JoseFuzzNo/performer-hardware/sequencer.pdf

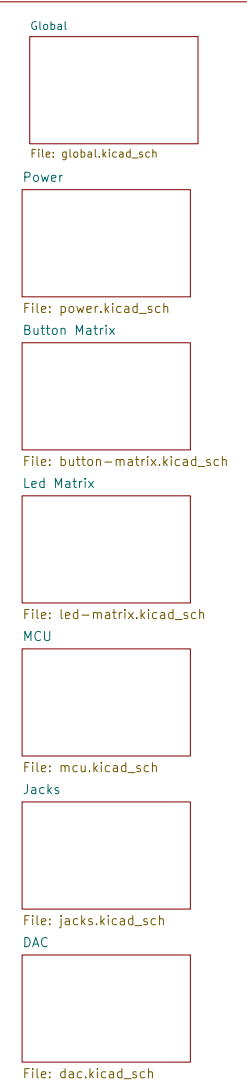
[picture p1: page 1]

Power File: power.kicad_sch Button Matrix File: button-matrix.kicad_sch

Led Matrix File: led-matrix.kicad_sch

File: sequencer.kicad_sch Sheet: / westlicht cc-by-nc-sa

Id: 1/8 Title: PER|FORMER eurorack sequencer

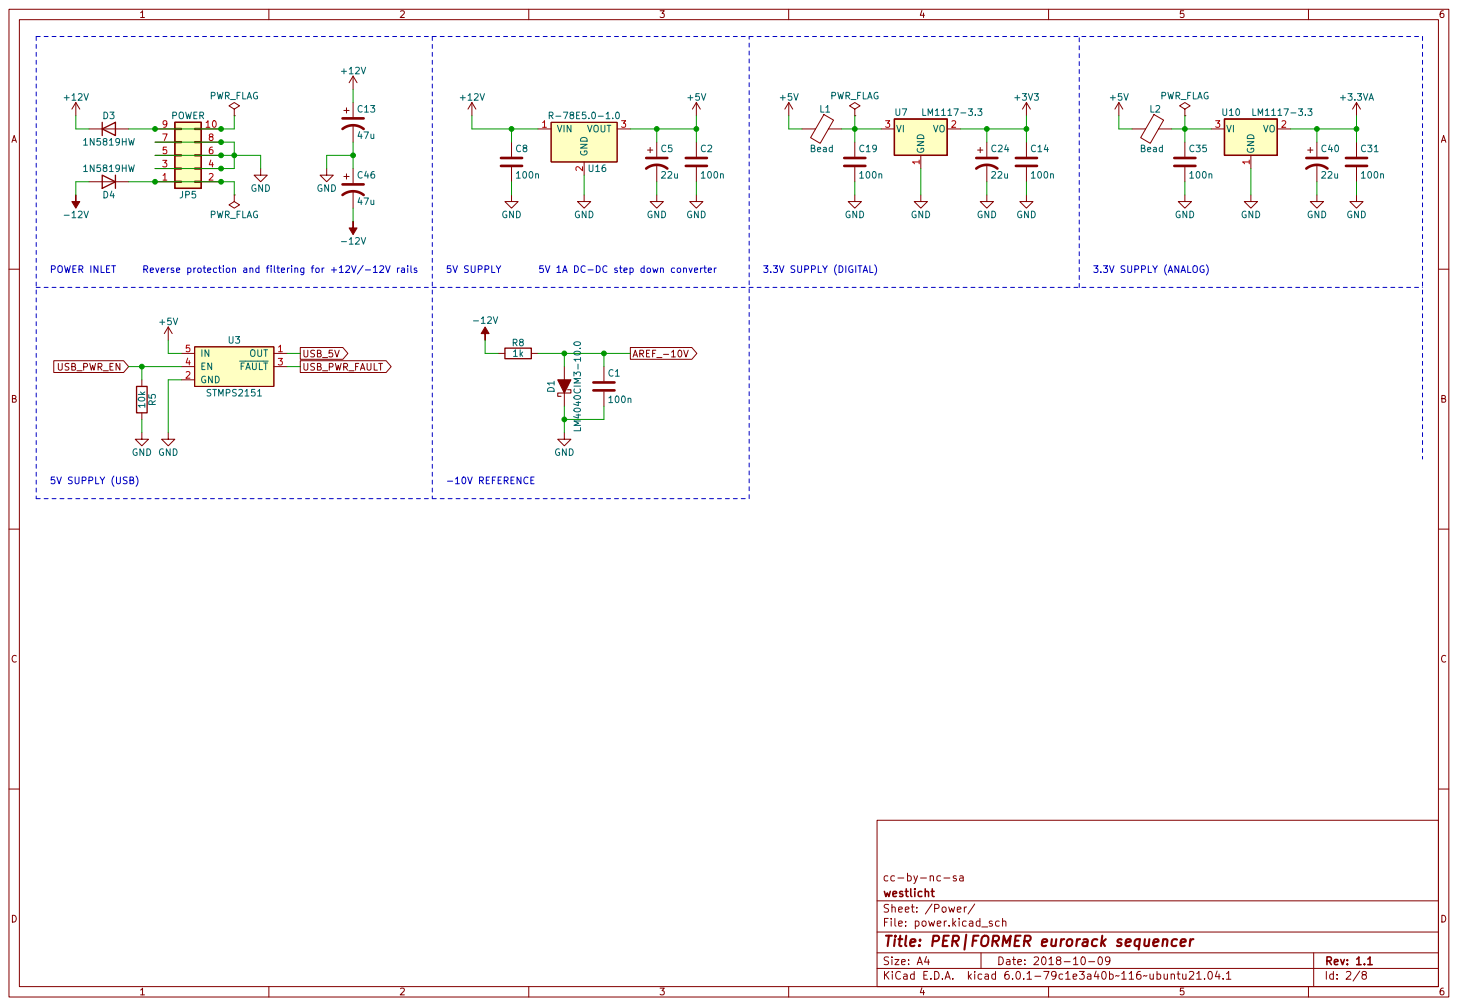
[picture p2: page 2]

Id: 2/8 Title: PER|FORMER eurorack sequencer

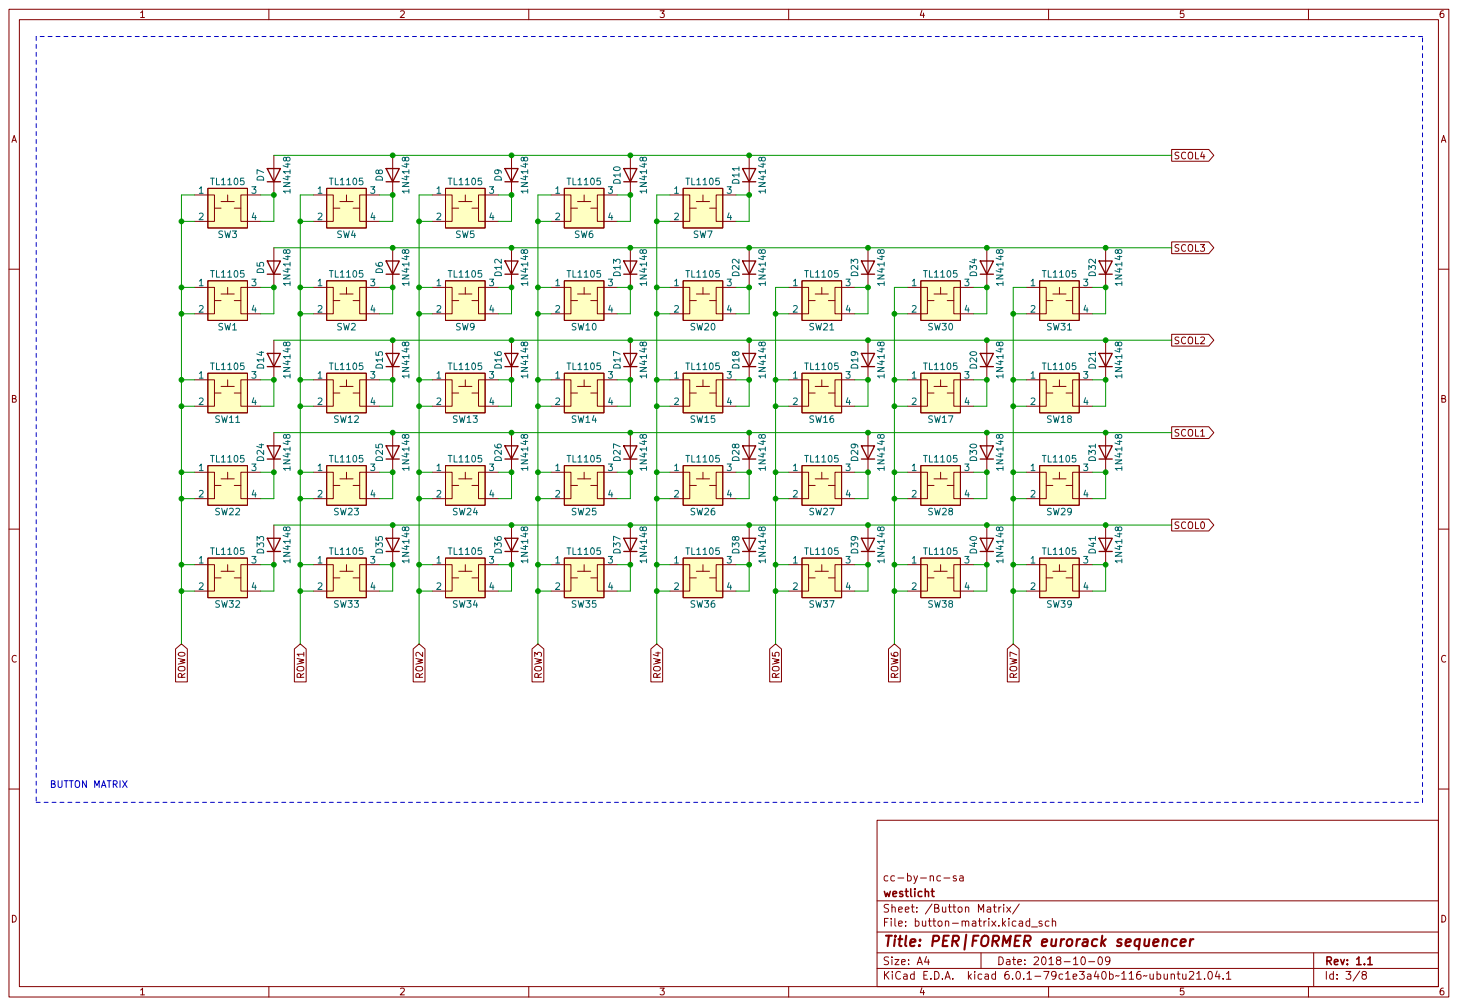
[picture p3: page 3]

File: button-matrix.kicad_sch Sheet: /Button Matrix/ westlicht cc-by-nc-sa

Id: 3/8 Title: PER|FORMER eurorack sequencer

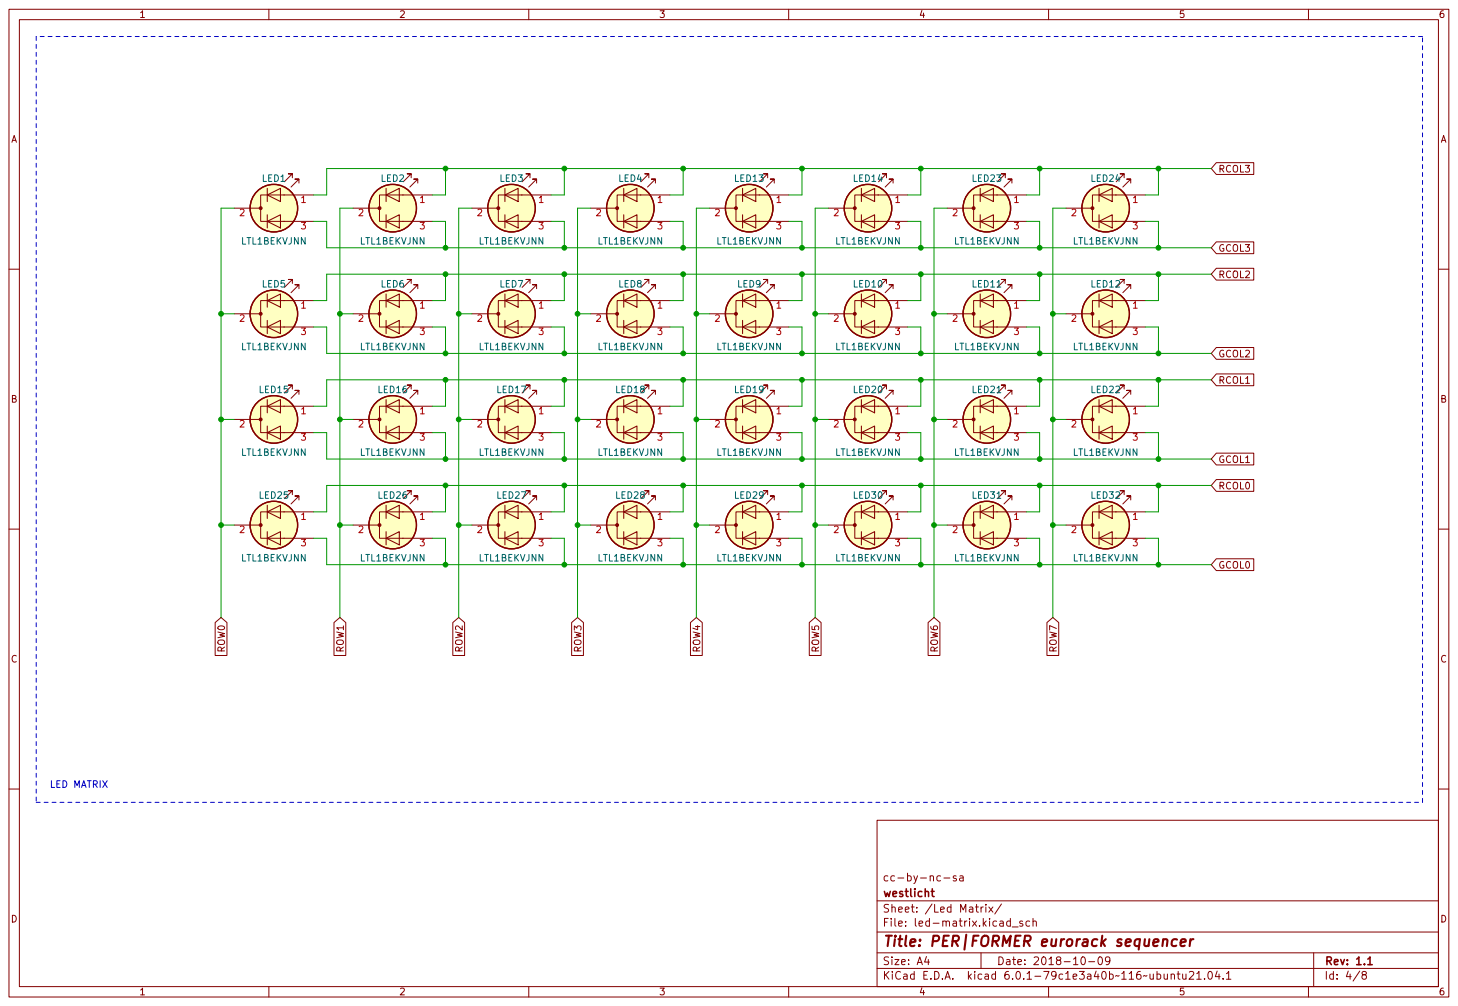
[picture p4: page 4]

File: led-matrix.kicad_sch Sheet: /Led Matrix/ westlicht cc-by-nc-sa

Id: 4/8 Title: PER|FORMER eurorack sequencer

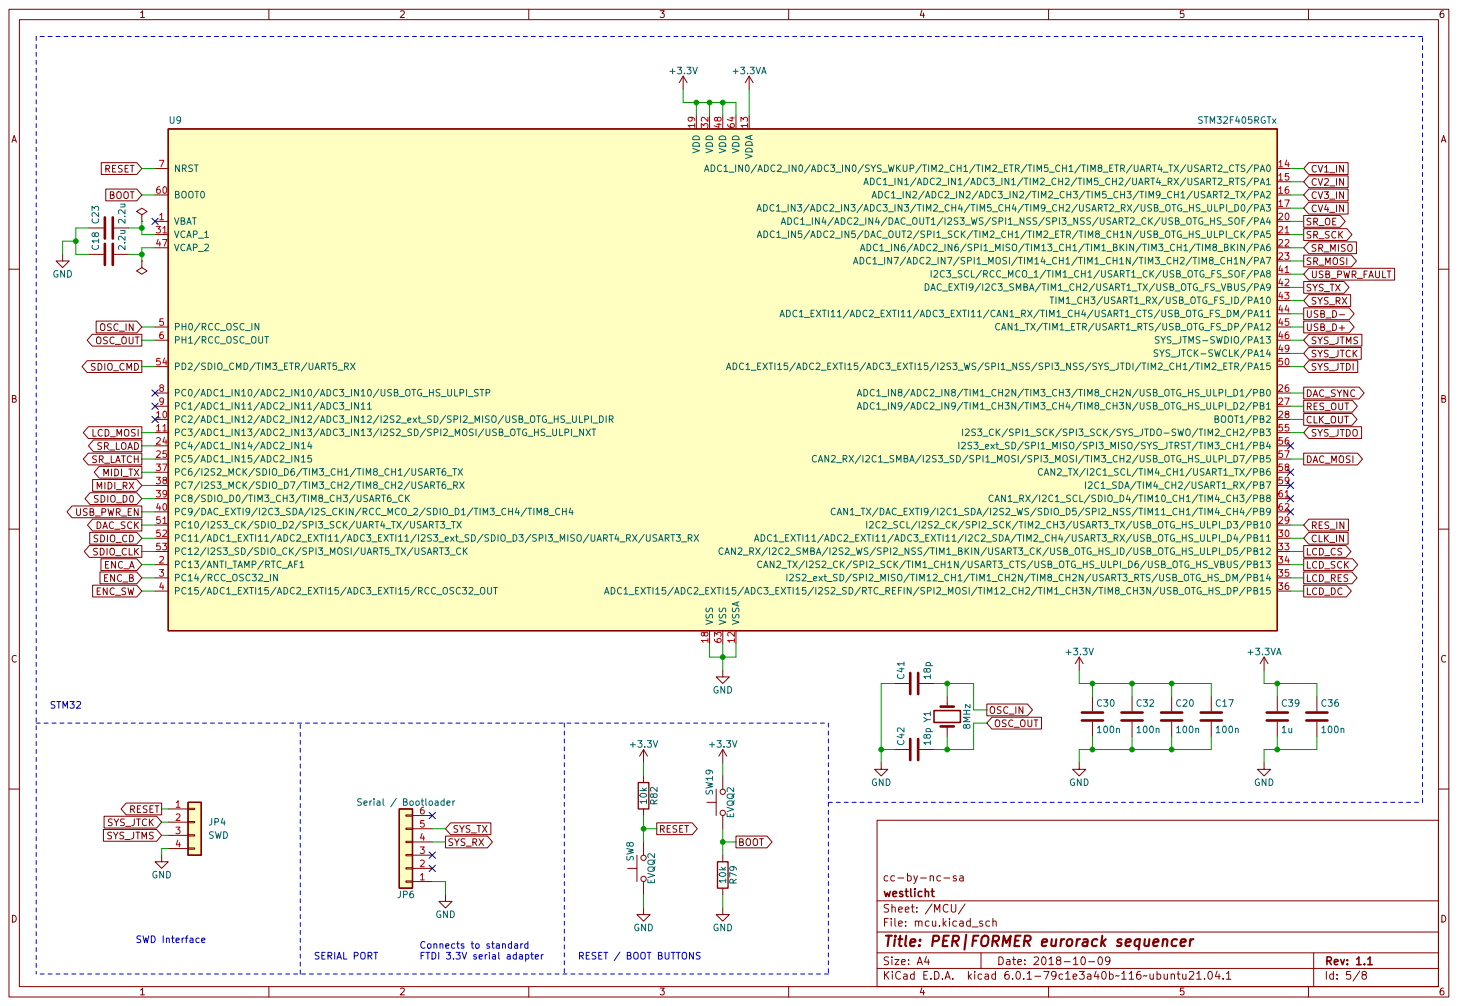
[picture p5: page 5]

Id: 5/8 Title: PER|FORMER eurorack sequencer

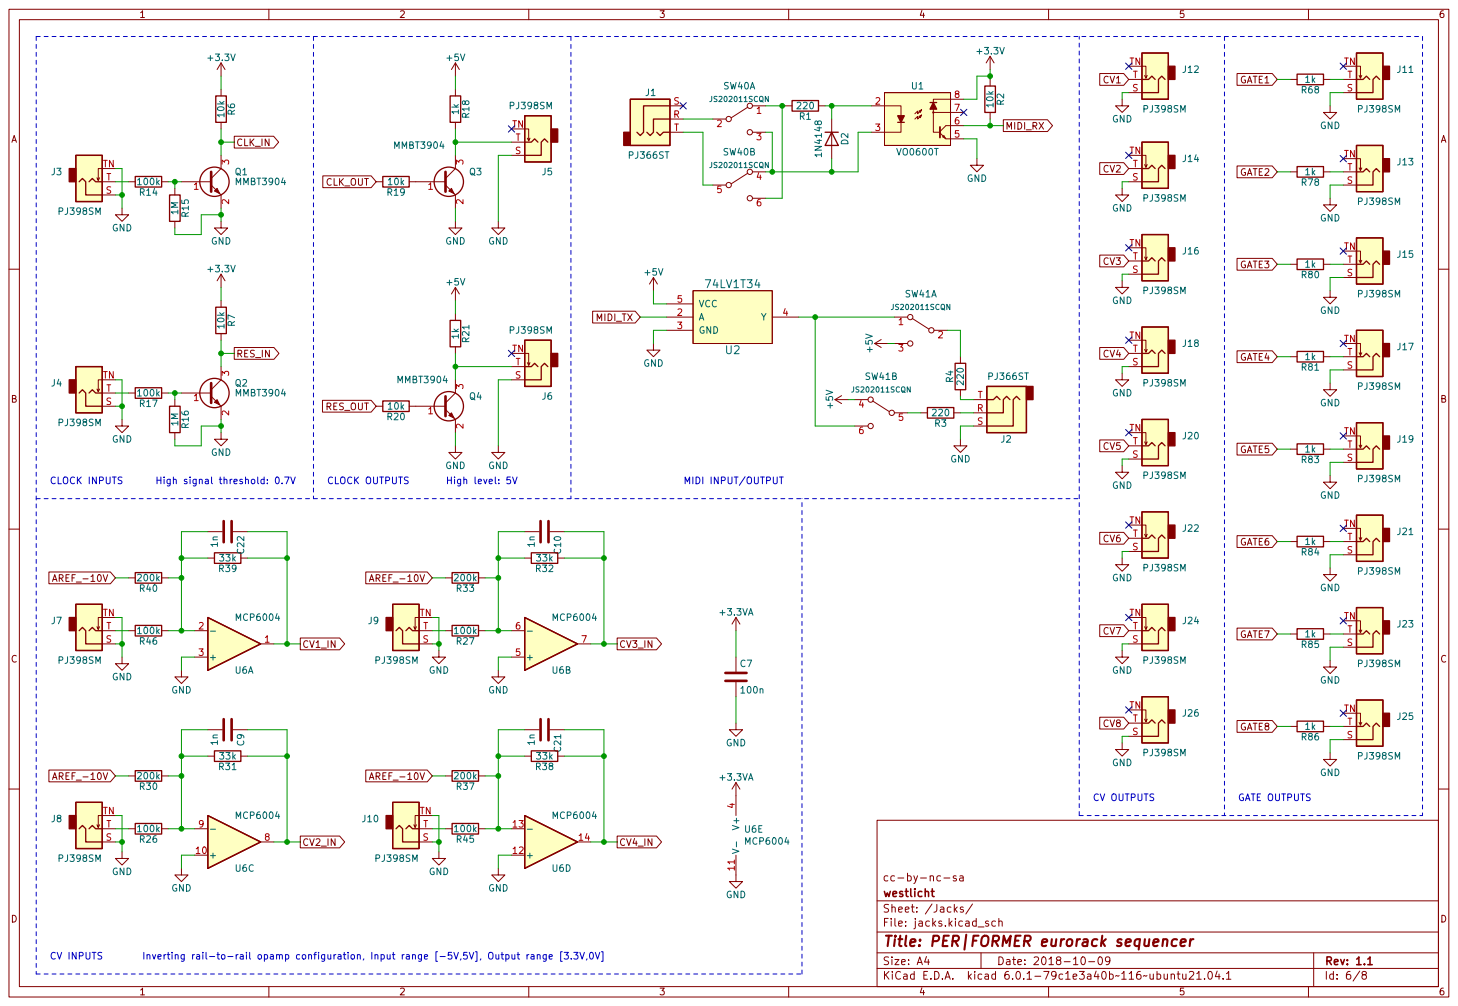
[picture p6: page 6]

File: jacks.kicad_sch Sheet: /Jacks/ westlicht cc-by-nc-sa

Id: 6/8 Title: PER|FORMER eurorack sequencer

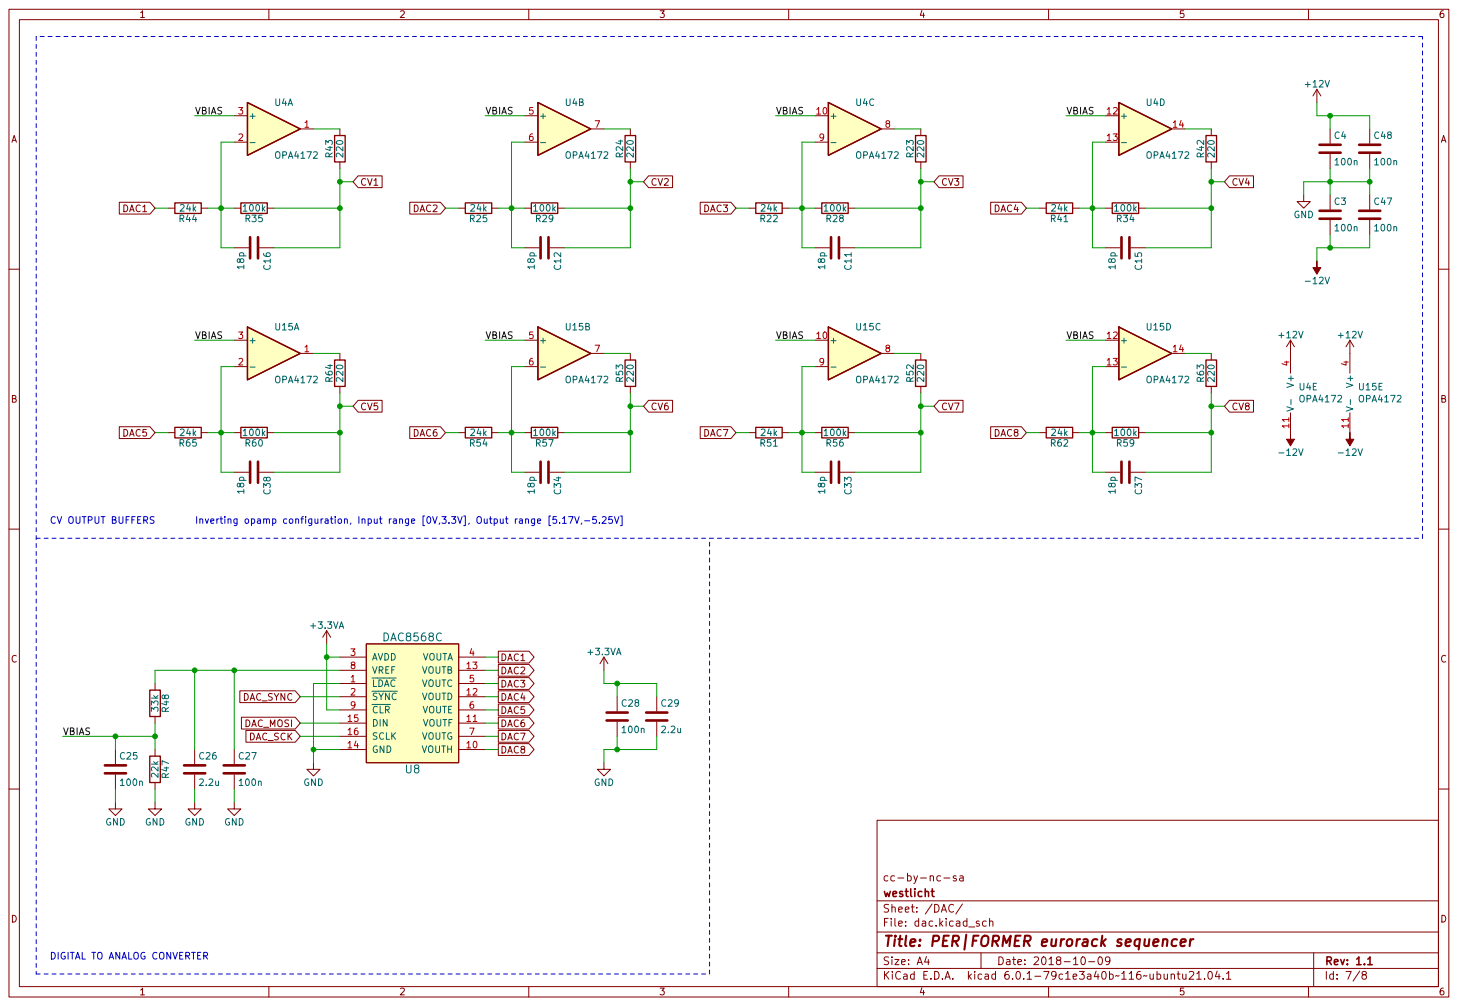
[picture p7: page 7]

File: dac.kicad_sch Sheet: /DAC/ westlicht cc-by-nc-sa R56

Id: 7/8 Title: PER|FORMER eurorack sequencer

DIGITAL TO ANALOG CONVERTER

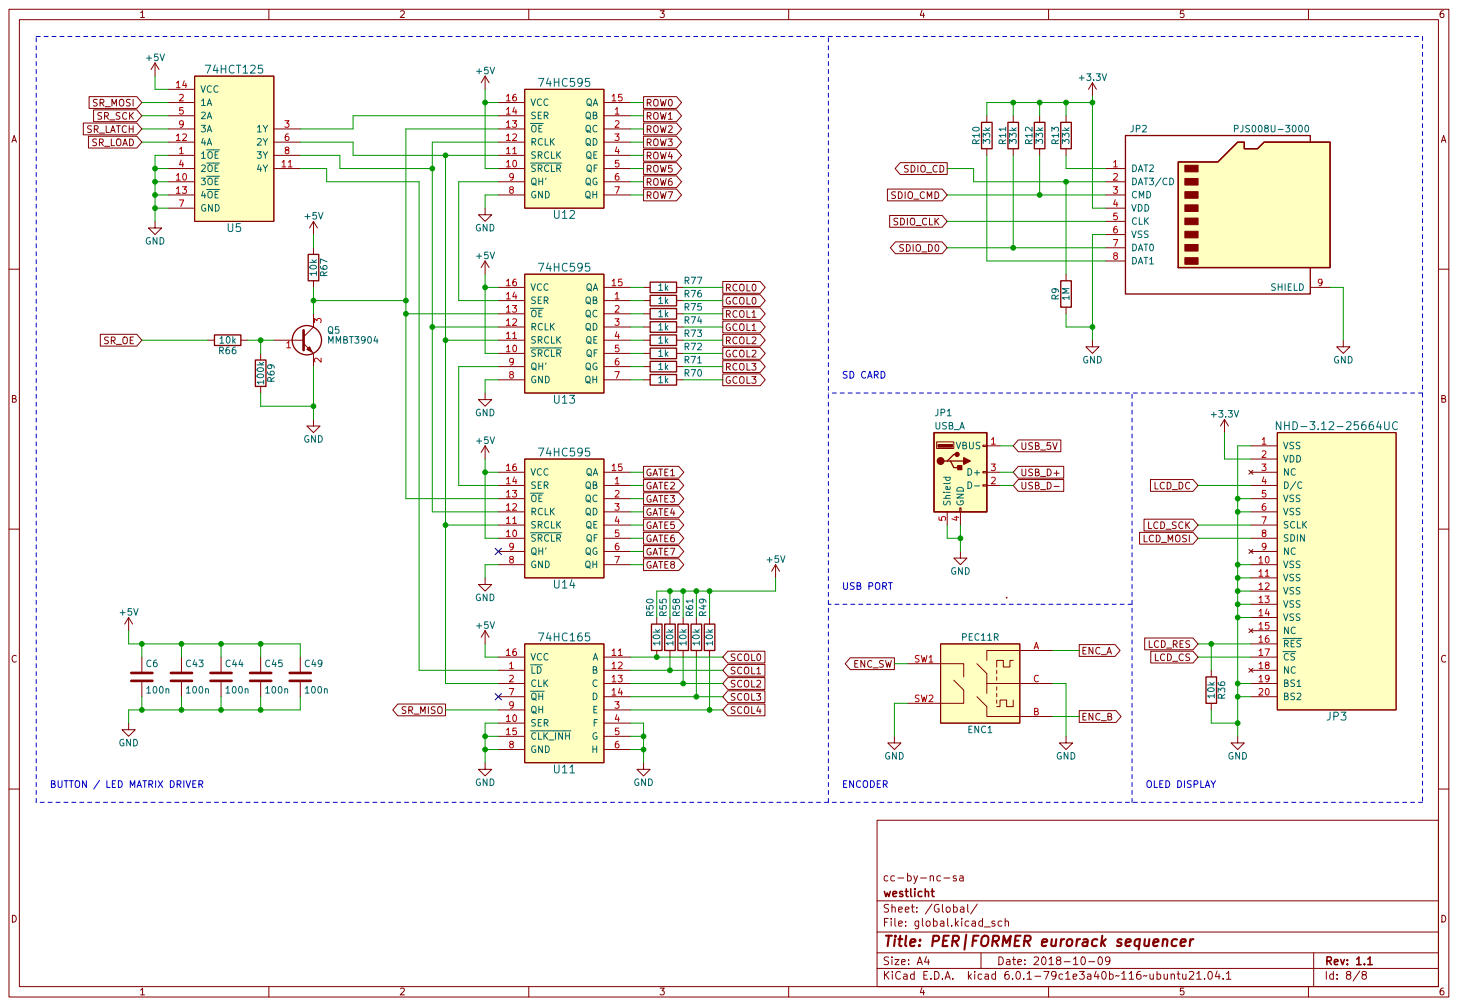
[picture p8: page 8]

2 3 Q5MMBT3904 QB 1 ~{SRCLR} 10 SRCLK 11 RCLK 12 ~{OE} 13 SER 14 QA 15 VCC 16 QC 2 QD 3 QE 4 QF 5 QG 6 QH 7 GND 8 QH' 9 U14

File: global.kicad_sch Sheet: /Global/ westlicht cc-by-nc-sa C45

Id: 8/8 Title: PER|FORMER eurorack sequencer
