JoseFuzzNo/performer-hardware/button-matrix.kicad_sch

## KiCad design button-matrix.kicad_sch (2023-10-19)

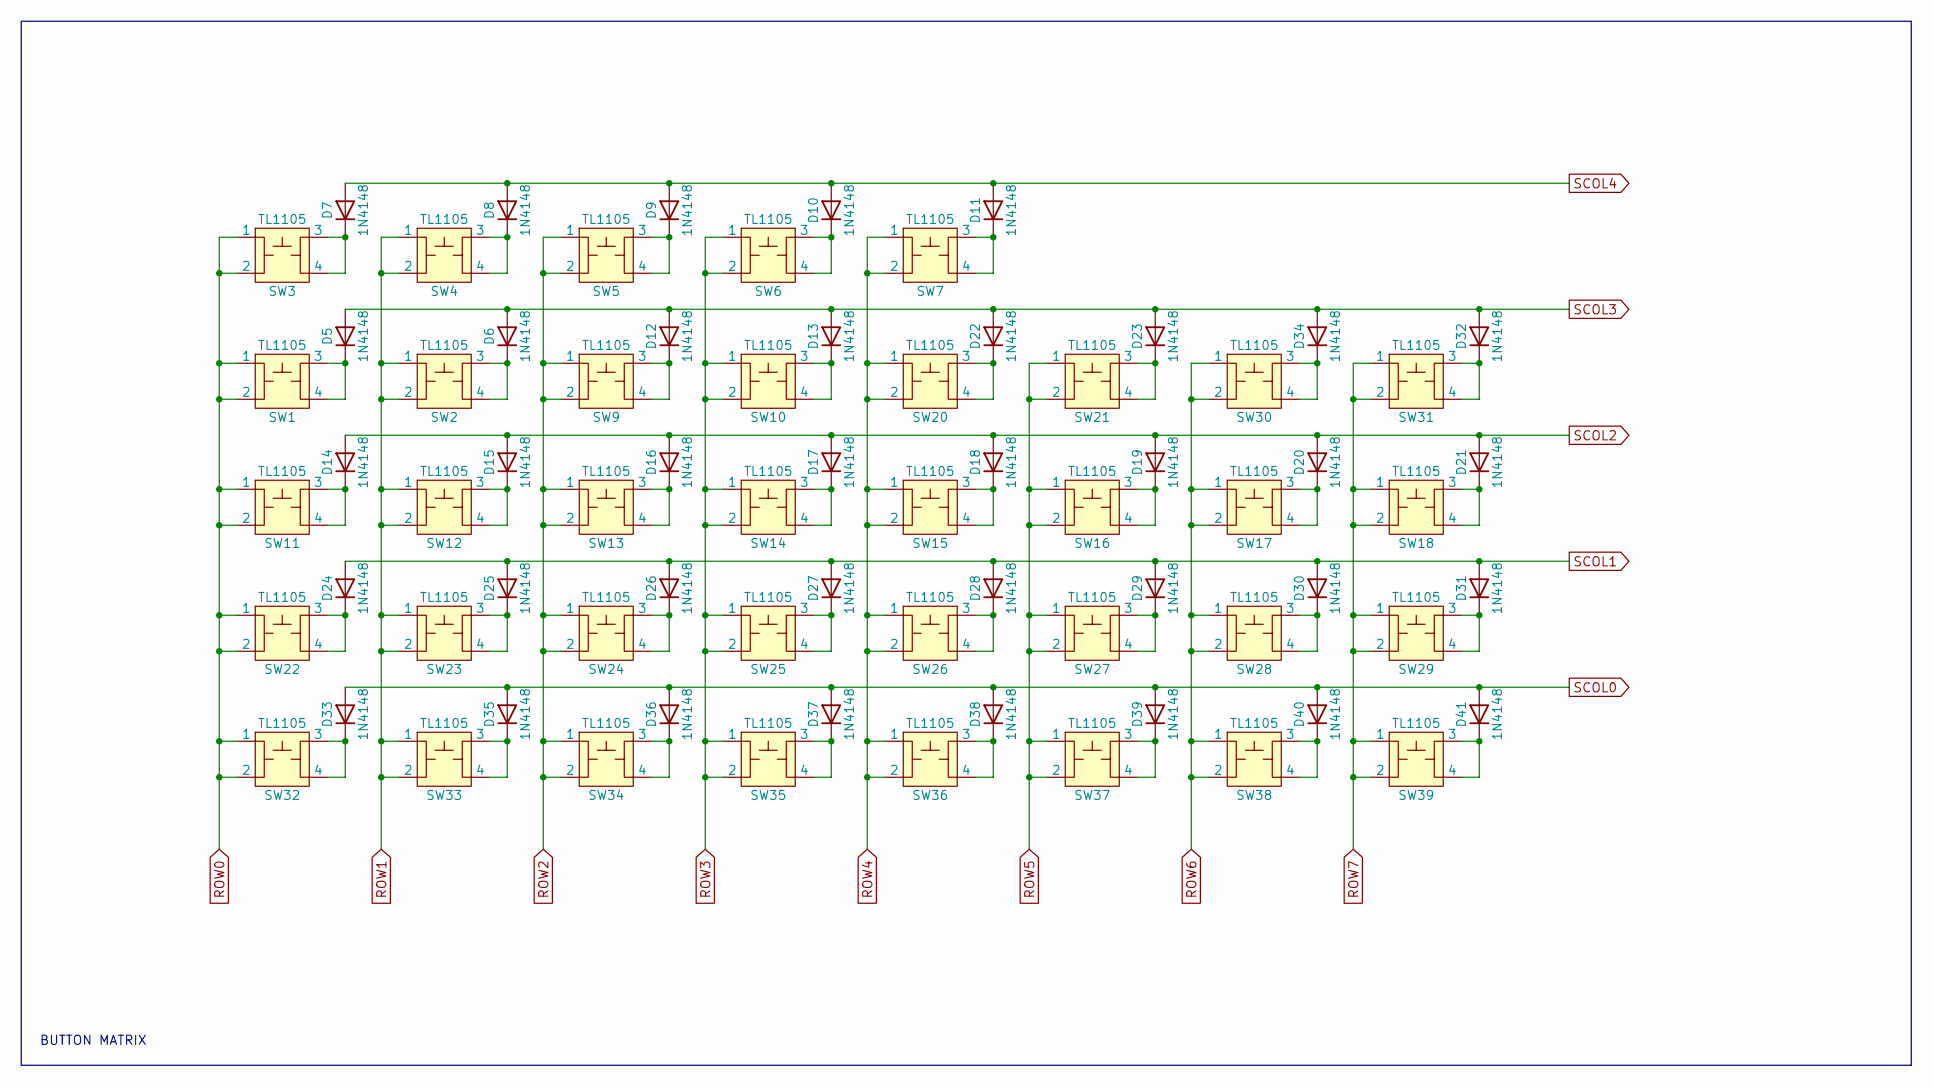
[picture p9: schematic button-matrix.kicad_sch]

Parts:
D5, D6, D7, D8, D9, D10, D11, D12, D13, D14, D15, D16, D17, D18, D19, D20, D21, D22, D23, D24, D25, D26, D27, D28, D29, D30, D31, D32, D33, D34, D35, D36, D37, D38, D39, D40, D41: 1N4148; D_SOD-123
SW1, SW2, SW3, SW4, SW5, SW6, SW7, SW9, SW10, SW11, SW12, SW13, SW14, SW15, SW16, SW17, SW18, SW20, SW21, SW22, SW23, SW24, SW25, SW26, SW27, SW28, SW29, SW30, SW31, SW32, SW33, SW34, SW35, SW36, SW37, SW38, SW39: TL1105; TL1105T

Connections:
unnamed: D5.1 (K), SW1.3, SW1.4
unnamed: D6.1 (K), SW2.3, SW2.4
unnamed: D7.1 (K), SW3.3, SW3.4
unnamed: D8.1 (K), SW4.3, SW4.4
unnamed: D9.1 (K), SW5.3, SW5.4
unnamed: D10.1 (K), SW6.3, SW6.4
unnamed: D11.1 (K), SW7.3, SW7.4
unnamed: D12.1 (K), SW9.3, SW9.4
unnamed: D13.1 (K), SW10.3, SW10.4
unnamed: D14.1 (K), SW11.3, SW11.4
unnamed: D15.1 (K), SW12.3, SW12.4
unnamed: D16.1 (K), SW13.3, SW13.4
unnamed: D17.1 (K), SW14.3, SW14.4
unnamed: D18.1 (K), SW15.3, SW15.4
unnamed: D19.1 (K), SW16.3, SW16.4
unnamed: D20.1 (K), SW17.3, SW17.4
unnamed: D21.1 (K), SW18.3, SW18.4
unnamed: D22.1 (K), SW20.3, SW20.4
unnamed: D23.1 (K), SW21.3, SW21.4
unnamed: D24.1 (K), SW22.3, SW22.4
unnamed: D25.1 (K), SW23.3, SW23.4
unnamed: D26.1 (K), SW24.3, SW24.4
unnamed: D27.1 (K), SW25.3, SW25.4
unnamed: D28.1 (K), SW26.3, SW26.4
unnamed: D29.1 (K), SW27.3, SW27.4
unnamed: D30.1 (K), SW28.3, SW28.4
unnamed: D31.1 (K), SW29.3, SW29.4
unnamed: D32.1 (K), SW31.3, SW31.4
unnamed: D33.1 (K), SW32.3, SW32.4
unnamed: D34.1 (K), SW30.3, SW30.4
unnamed: D35.1 (K), SW33.3, SW33.4
unnamed: D36.1 (K), SW34.3, SW34.4
unnamed: D37.1 (K), SW35.3, SW35.4
unnamed: D38.1 (K), SW36.3, SW36.4
unnamed: D39.1 (K), SW37.3, SW37.4
unnamed: D40.1 (K), SW38.3, SW38.4
unnamed: D41.1 (K), SW39.3, SW39.4
ROW0: SW1.1, SW1.2, SW3.1, SW3.2, SW11.1, SW11.2, SW22.1, SW22.2, SW32.1, SW32.2
ROW1: SW2.1, SW2.2, SW4.1, SW4.2, SW12.1, SW12.2, SW23.1, SW23.2, SW33.1, SW33.2
ROW2: SW5.1, SW5.2, SW9.1, SW9.2, SW13.1, SW13.2, SW24.1, SW24.2, SW34.1, SW34.2
ROW3: SW6.1, SW6.2, SW10.1, SW10.2, SW14.1, SW14.2, SW25.1, SW25.2, SW35.1, SW35.2
ROW4: SW7.1, SW7.2, SW15.1, SW15.2, SW20.1, SW20.2, SW26.1, SW26.2, SW36.1, SW36.2
ROW5: SW16.1, SW16.2, SW21.1, SW21.2, SW27.1, SW27.2, SW37.1, SW37.2
ROW6: SW17.1, SW17.2, SW28.1, SW28.2, SW30.1, SW30.2, SW38.1, SW38.2
ROW7: SW18.1, SW18.2, SW29.1, SW29.2, SW31.1, SW31.2, SW39.1, SW39.2
SCOL0: D33.2 (A), D35.2 (A), D36.2 (A), D37.2 (A), D38.2 (A), D39.2 (A), D40.2 (A), D41.2 (A)
SCOL1: D24.2 (A), D25.2 (A), D26.2 (A), D27.2 (A), D28.2 (A), D29.2 (A), D30.2 (A), D31.2 (A)
SCOL2: D14.2 (A), D15.2 (A), D16.2 (A), D17.2 (A), D18.2 (A), D19.2 (A), D20.2 (A), D21.2 (A)
SCOL3: D5.2 (A), D6.2 (A), D12.2 (A), D13.2 (A), D22.2 (A), D23.2 (A), D32.2 (A), D34.2 (A)
SCOL4: D7.2 (A), D8.2 (A), D9.2 (A), D10.2 (A), D11.2 (A)

Notes on the sheet:
BUTTON MATRIX
