JoseFuzzNo/performer-hardware/global.kicad_sch

## KiCad design global.kicad_sch (2023-10-19)

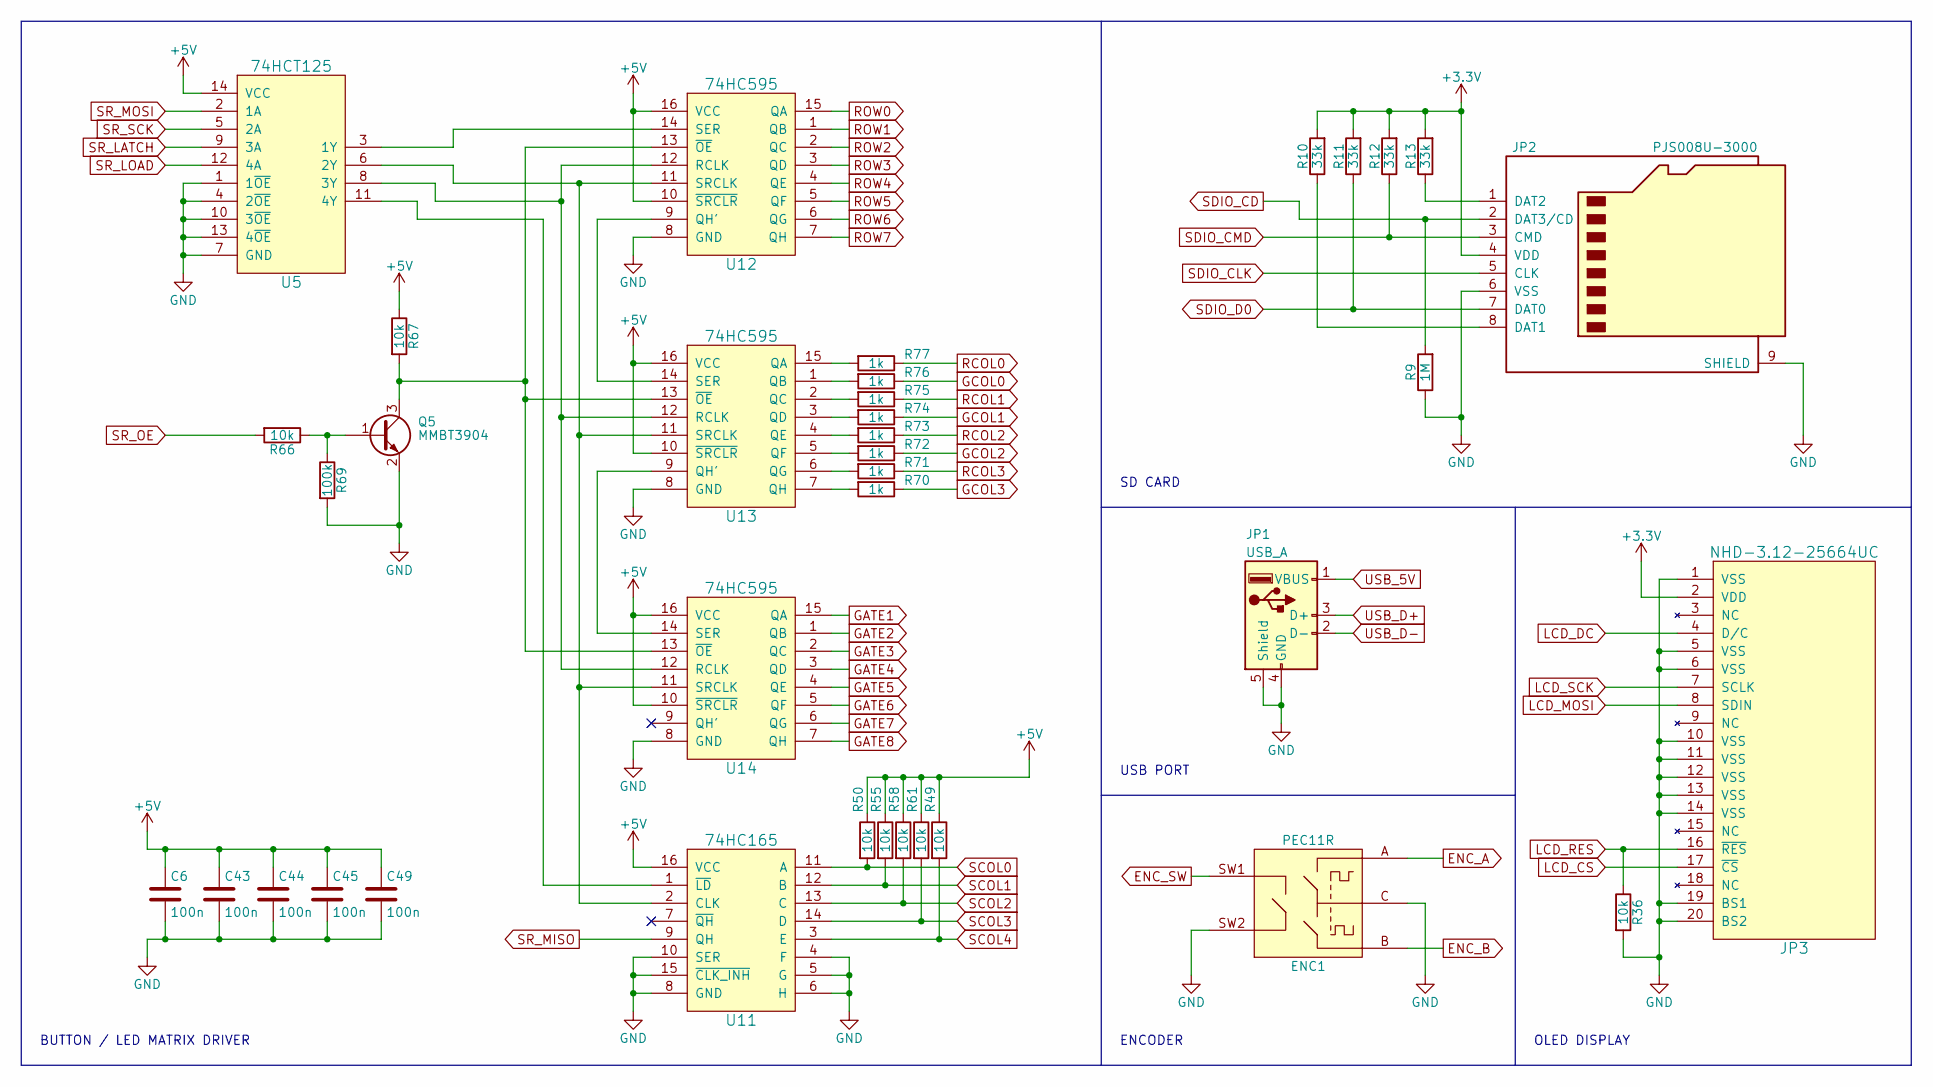
[picture p11: schematic global.kicad_sch]

Parts:
C6, C43, C44, C45, C49: 100n; C_0603
ENC1: PEC11R; ALPS_STEC12E08
JP1: USB_A; MOLEX_USB_105057
JP2: PJS008U-3000; PJS008U-3000-0
JP3: NHD-3.12-25664UC
Q5: MMBT3904; SOT-23
R9: 1M; R_0603
R10, R11, R12, R13: 33k; R_0603
R36, R49, R50, R55, R58, R61, R66, R67: 10k; R_0603
R69: 100k; R_0603
R70, R71, R72, R73, R74, R75, R76, R77: 1k; R_0603
U5: 74HCT125; SOIC-14_3.9x8.7mm_P1.27mm
U11: 74HC165; SOIC-16_3.9x9.9mm_P1.27mm
U12, U13, U14: 74HC595; SOIC-16_3.9x9.9mm_P1.27mm

Connections:
+3.3V: JP2.4 (VDD), JP3.2 (VDD), R10.2, R11.2, R12.2, R13.2
+5V: C6.1, C43.1, C44.1, C45.1, C49.1, R49.1, R50.1, R55.1, R58.1, R61.1, R67.1, U5.14 (VCC), U11.16 (VCC), U12.10 (~SRCLR), U12.16 (VCC), U13.10 (~SRCLR), U13.16 (VCC), U14.10 (~SRCLR), U14.16 (VCC)
ENC_A: ENC1.A
ENC_B: ENC1.B
ENC_SW: ENC1.SW1
GATE1: U14.15 (QA)
GATE2: U14.1 (QB)
GATE3: U14.2 (QC)
GATE4: U14.3 (QD)
GATE5: U14.4 (QE)
GATE6: U14.5 (QF)
GATE7: U14.6 (QG)
GATE8: U14.7 (QH)
GCOL0: R76.1
GCOL1: R74.1
GCOL2: R72.1
GCOL3: R70.1
GND: C6.2, C43.2, C44.2, C45.2, C49.2, ENC1.C, ENC1.SW2, JP1.4 (GND), JP1.5 (Shield), JP2.6 (VSS), JP2.9 (SHIELD), JP3.1 (VSS), JP3.5 (VSS), JP3.6 (VSS), JP3.10 (VSS), JP3.11 (VSS), JP3.12 (VSS), JP3.13 (VSS), JP3.14 (VSS), JP3.19 (BS1), JP3.20 (BS2), Q5.2 (E), R9.1, R36.2, R69.2, U5.1 (1~OE), U5.4 (2~OE), U5.7 (GND), U5.10 (3~OE), U5.13 (4~OE), U11.4 (F), U11.5 (G), U11.6 (H), U11.8 (GND), U11.10 (SER), U11.15 (~CLK_INH), U12.8 (GND), U13.8 (GND), U14.8 (GND)
LCD_CS: JP3.17 (~CS)
LCD_DC: JP3.4 (D/C)
LCD_MOSI: JP3.8 (SDIN)
LCD_RES: JP3.16 (~RES), R36.1
LCD_SCK: JP3.7 (SCLK)
unnamed: JP2.1 (DAT2), R13.1
unnamed: JP2.8 (DAT1), R10.1
unnamed: Q5.1 (B), R66.1, R69.1
unnamed: Q5.3 (C), R67.2, U12.13 (~OE), U13.13 (~OE), U14.13 (~OE)
unnamed: R70.2, U13.7 (QH)
unnamed: R71.2, U13.6 (QG)
unnamed: R72.2, U13.5 (QF)
unnamed: R73.2, U13.4 (QE)
unnamed: R74.2, U13.3 (QD)
unnamed: R75.2, U13.2 (QC)
unnamed: R76.2, U13.1 (QB)
unnamed: R77.2, U13.15 (QA)
unnamed: U5.11 (4Y), U11.1 (~LD)
unnamed: U5.6 (2Y), U11.2 (CLK), U12.11 (SRCLK), U13.11 (SRCLK), U14.11 (SRCLK)
unnamed: U12.9 (QH'), U13.14 (SER)
unnamed: U5.8 (3Y), U12.12 (RCLK), U13.12 (RCLK), U14.12 (RCLK)
unnamed: U5.3 (1Y), U12.14 (SER)
unnamed: U13.9 (QH'), U14.14 (SER)
RCOL0: R77.1
RCOL1: R75.1
RCOL2: R73.1
RCOL3: R71.1
ROW0: U12.15 (QA)
ROW1: U12.1 (QB)
ROW2: U12.2 (QC)
ROW3: U12.3 (QD)
ROW4: U12.4 (QE)
ROW5: U12.5 (QF)
ROW6: U12.6 (QG)
ROW7: U12.7 (QH)
SCOL0: R50.2, U11.11 (A)
SCOL1: R55.2, U11.12 (B)
SCOL2: R58.2, U11.13 (C)
SCOL3: R61.2, U11.14 (D)
SCOL4: R49.2, U11.3 (E)
SDIO_CD: JP2.2 (DAT3/CD), R9.2
SDIO_CLK: JP2.5 (CLK)
SDIO_CMD: JP2.3 (CMD), R12.1
SDIO_D0: JP2.7 (DAT0), R11.1
SR_LATCH: U5.9 (3A)
SR_LOAD: U5.12 (4A)
SR_MISO: U11.9 (QH)
SR_MOSI: U5.2 (1A)
SR_OE: R66.2
SR_SCK: U5.5 (2A)
USB_5V: JP1.1 (VBUS)
USB_D+: JP1.3 (D+)
USB_D-: JP1.2 (D-)

Notes on the sheet:
OLED DISPLAY
USB PORT
BUTTON / LED MATRIX DRIVER
ENCODER
SD CARD
