JoseFuzzNo/performer-hardware/jacks.kicad_sch

## KiCad design jacks.kicad_sch (2023-10-19)

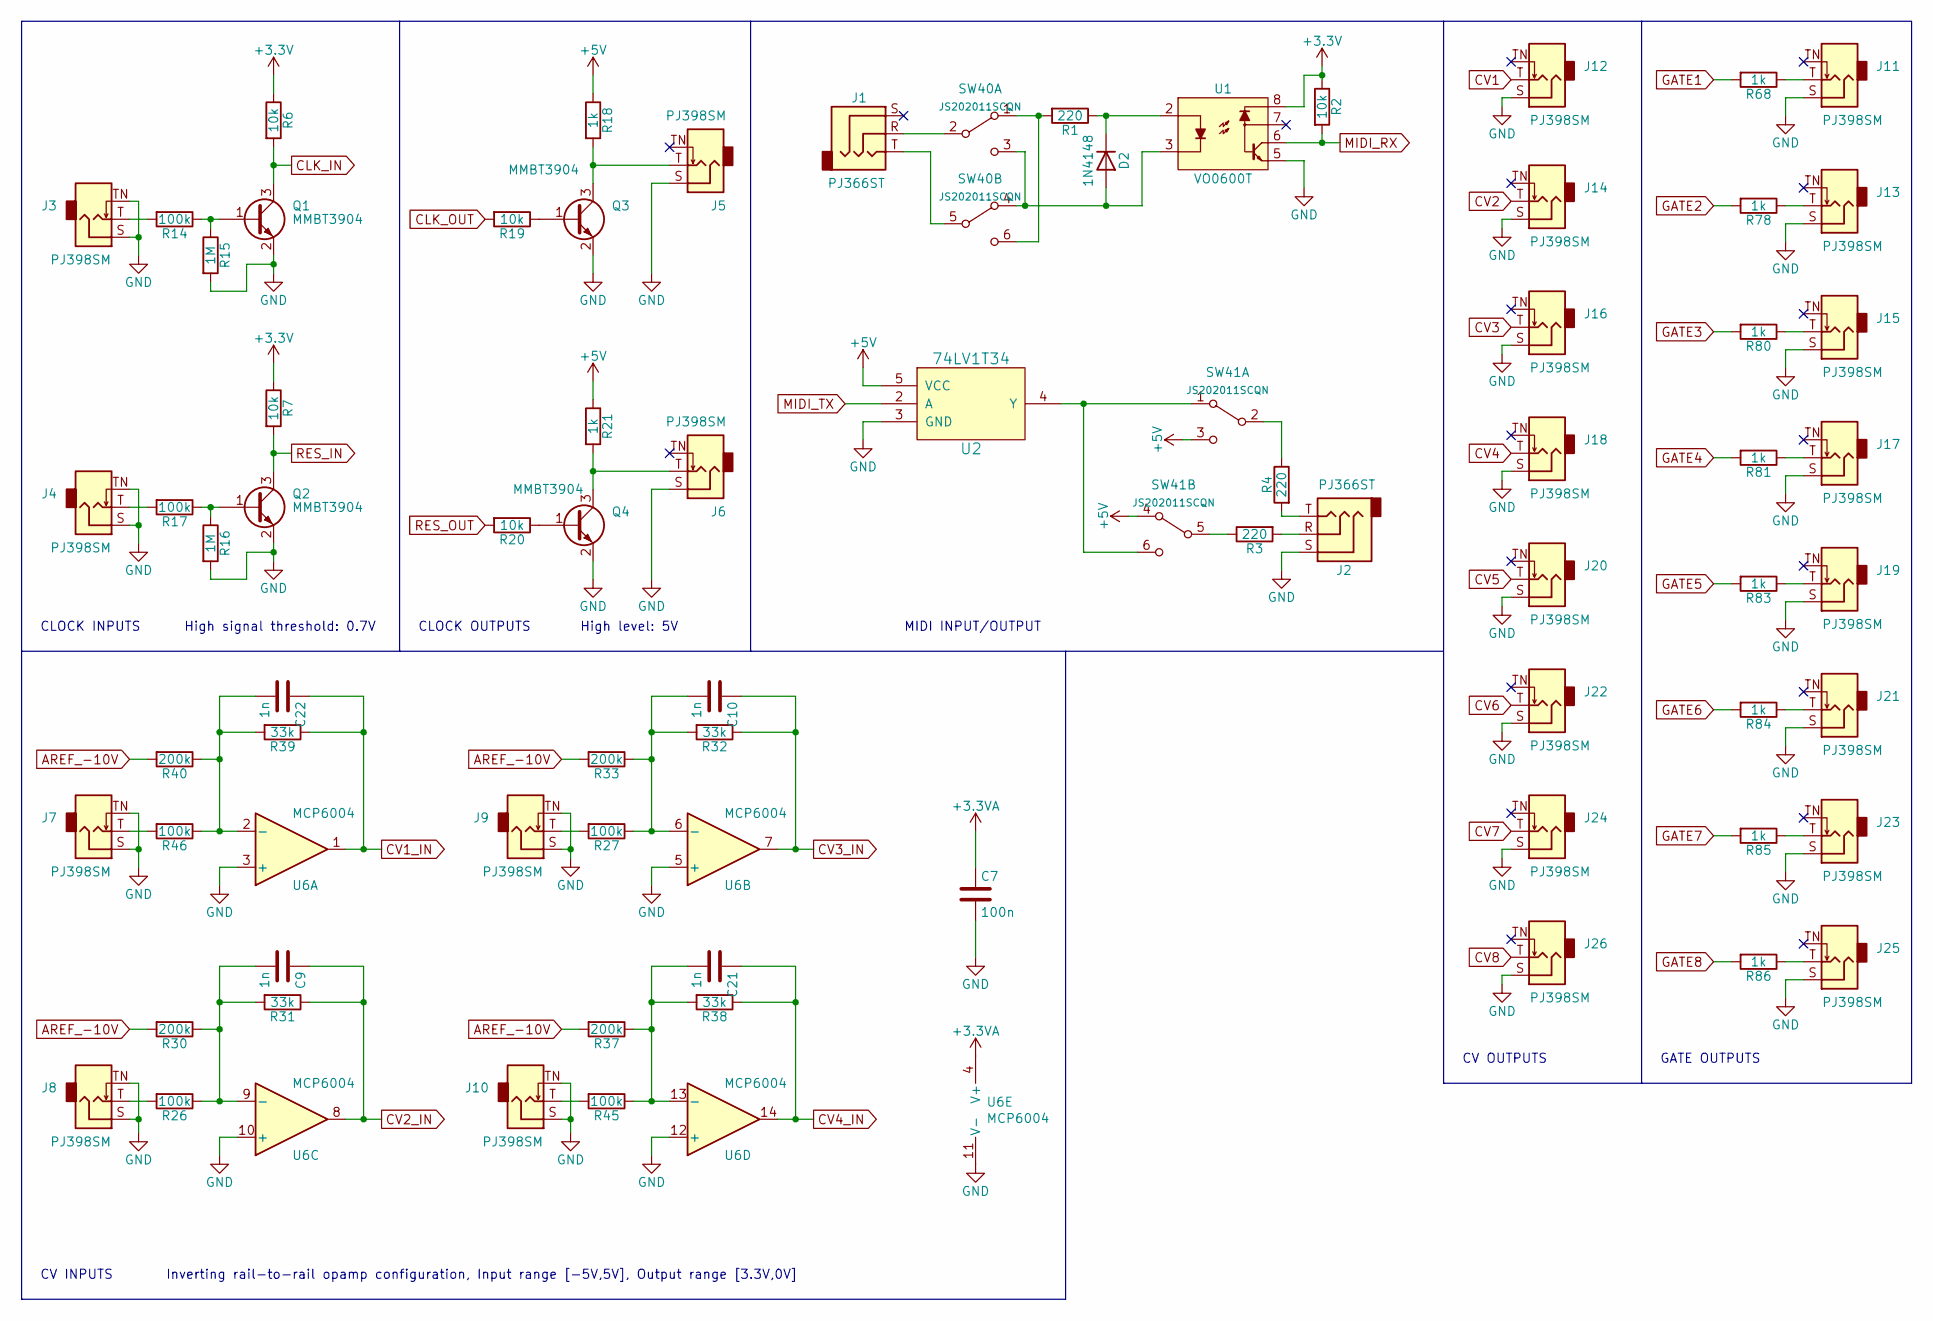
[picture p12: schematic jacks.kicad_sch]

Parts:
C7: 100n; C_0603
C9, C10, C21, C22: 1n; C_0603
D2: 1N4148; D_SOD-123
J1, J2: PJ366ST; Jack_3.5mm_QingPu_WQP-PJ366ST_Vertical_CircularHoles_WithDr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
J3, J4, J5, J6, J7, J8, J9, J10, J11, J12, J13, J14, J15, J16, J17, J18, J19, J20, J21, J22, J23, J24, J25, J26: PJ398SM; Jack_3.5mm_QingPu_WQP-PJ398SM_Vertical_CircularHoles_WithDr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
Q1, Q2, Q3, Q4: MMBT3904; SOT-23
R1, R3, R4: 220; R_0603
R2, R6, R7, R19, R20: 10k; R_0603
R14, R17, R26, R27, R45, R46: 100k; R_0603
R15, R16: 1M; R_0603
R18, R21, R68, R78, R80, R81, R83, R84, R85, R86: 1k; R_0603
R30, R33, R37, R40: 200k; R_0603
R31, R32, R38, R39: 33k; R_0603
SW40, SW41: JS202011SCQN; SW_DPDT_CK_JS202011SCQN
U1: VO0600T; SOIC-8_3.9x4.9mm_P1.27mm
U2: 74LV1T34; SOT-23-5
U6: MCP6004; SOIC-14_3.9x8.7mm_P1.27mm

Connections:
+3.3V: R2.1, R6.1, R7.1, U1.8
+3.3VA: C7.1, U6.4 (V+)
+5V: R18.1, R21.1, SW41.3 (C), SW41.4 (A), U2.5 (VCC)
AREF_-10V: R30.2, R33.2, R37.2, R40.2
CLK_IN: Q1.3 (C), R6.2
CLK_OUT: R19.2
CV1: J12.T
CV1_IN: C22.1, R39.1, U6.1
CV2: J14.T
CV2_IN: C9.1, R31.1, U6.8
CV3: J16.T
CV3_IN: C10.1, R32.1, U6.7
CV4: J18.T
CV4_IN: C21.1, R38.1, U6.14
CV5: J20.T
CV6: J22.T
CV7: J24.T
CV8: J26.T
GATE1: R68.2
GATE2: R78.2
GATE3: R80.2
GATE4: R81.2
GATE5: R83.2
GATE6: R84.2
GATE7: R85.2
GATE8: R86.2
GND: C7.2, J2.S, J3.S, J3.TN, J4.S, J4.TN, J5.S, J6.S, J7.S, J7.TN, J8.S, J8.TN, J9.S, J9.TN, J10.S, J10.TN, J11.S, J12.S, J13.S, J14.S, J15.S, J16.S, J17.S, J18.S, J19.S, J20.S, J21.S, J22.S, J23.S, J24.S, J25.S, J26.S, Q1.2 (E), Q2.2 (E), Q3.2 (E), Q4.2 (E), R15.2, R16.2, U1.5, U2.3 (GND), U6.3 (+), U6.5 (+), U6.10 (+), U6.11 (V-), U6.12 (+)
MIDI_RX: R2.2, U1.6
MIDI_TX: U2.2 (A)
unnamed: C9.2, R26.1, R30.1, R31.2, U6.9 (-)
unnamed: C10.2, R27.1, R32.2, R33.1, U6.6 (-)
unnamed: C21.2, R37.1, R38.2, R45.1, U6.13 (-)
unnamed: C22.2, R39.2, R40.1, R46.1, U6.2 (-)
unnamed: D2.1 (K), R1.1, U1.2
unnamed: D2.2 (A), SW40.3 (C), SW40.4 (A), U1.3
unnamed: J1.R, SW40.2 (B)
unnamed: J1.T, SW40.5 (B)
unnamed: J2.R, R3.2
unnamed: J2.T, R4.2
unnamed: J3.T, R14.2
unnamed: J4.T, R17.2
unnamed: J5.T, Q3.3 (C), R18.2
unnamed: J6.T, Q4.3 (C), R21.2
unnamed: J7.T, R46.2
unnamed: J8.T, R26.2
unnamed: J9.T, R27.2
unnamed: J10.T, R45.2
unnamed: J11.T, R68.1
unnamed: J13.T, R78.1
unnamed: J15.T, R80.1
unnamed: J17.T, R81.1
unnamed: J19.T, R83.1
unnamed: J21.T, R84.1
unnamed: J23.T, R85.1
unnamed: J25.T, R86.1
unnamed: Q1.1 (B), R14.1, R15.1
unnamed: Q2.1 (B), R16.1, R17.1
unnamed: Q3.1 (B), R19.1
unnamed: Q4.1 (B), R20.1
unnamed: R1.2, SW40.1 (A), SW40.6 (C)
unnamed: R3.1, SW41.5 (B)
unnamed: R4.1, SW41.2 (B)
unnamed: SW41.1 (A), SW41.6 (C), U2.4 (Y)
RES_IN: Q2.3 (C), R7.2
RES_OUT: R20.2

Notes on the sheet:
CLOCK INPUTS
MIDI INPUT/OUTPUT
CLOCK OUTPUTS
CV INPUTS
High level: 5V
Inverting rail-to-rail opamp configuration, Input range [-5V,5V], Output range [3.3V,0V]
High signal threshold: 0.7V
GATE OUTPUTS
CV OUTPUTS
