JoseFuzzNo/performer-hardware/led-matrix.kicad_sch

## KiCad design led-matrix.kicad_sch (2023-10-19)

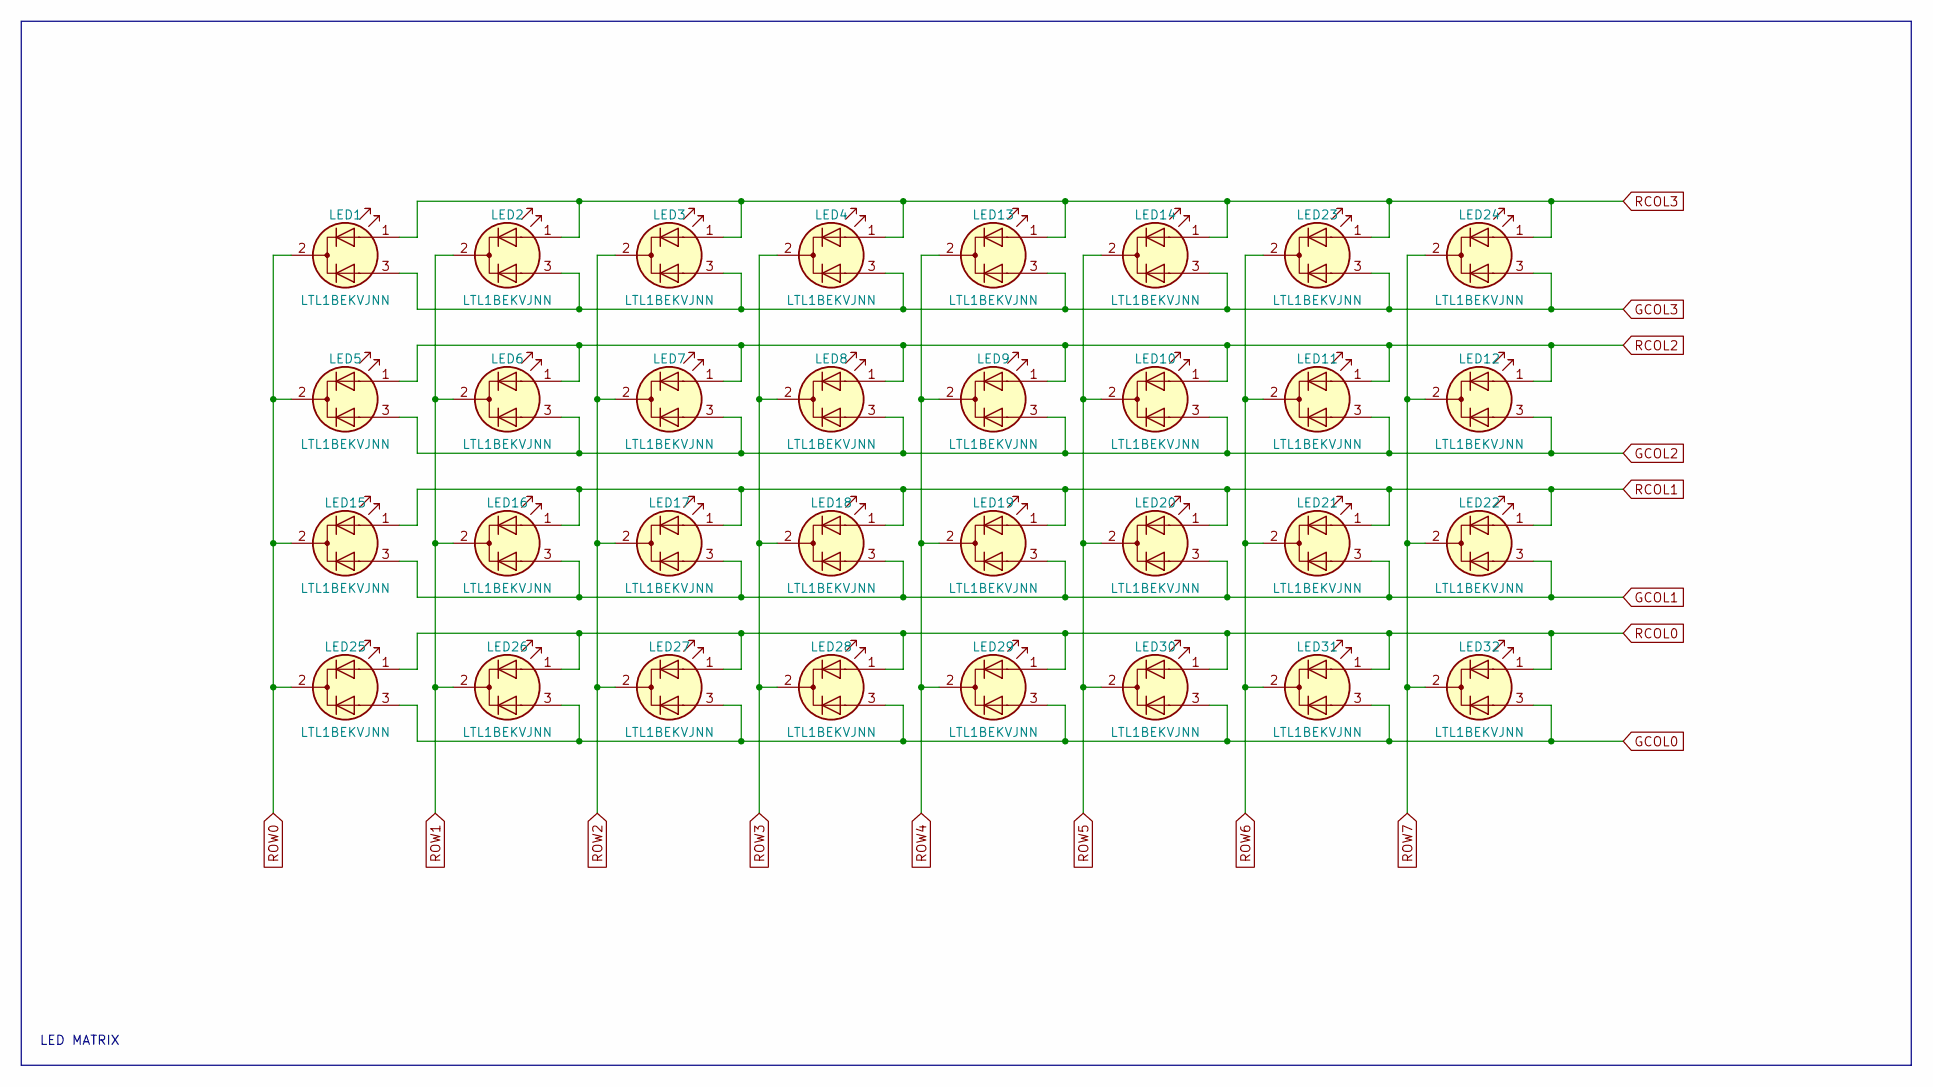
[picture p13: schematic led-matrix.kicad_sch]

Parts:
LED1, LED2, LED3, LED4, LED5, LED6, LED7, LED8, LED9, LED10, LED11, LED12, LED13, LED14, LED15, LED16, LED17, LED18, LED19, LED20, LED21, LED22, LED23, LED24, LED25, LED26, LED27, LED28, LED29, LED30, LED31, LED32: LTL1BEKVJNN

Connections:
GCOL0: LED25.3 (A2), LED26.3 (A2), LED27.3 (A2), LED28.3 (A2), LED29.3 (A2), LED30.3 (A2), LED31.3 (A2), LED32.3 (A2)
GCOL1: LED15.3 (A2), LED16.3 (A2), LED17.3 (A2), LED18.3 (A2), LED19.3 (A2), LED20.3 (A2), LED21.3 (A2), LED22.3 (A2)
GCOL2: LED5.3 (A2), LED6.3 (A2), LED7.3 (A2), LED8.3 (A2), LED9.3 (A2), LED10.3 (A2), LED11.3 (A2), LED12.3 (A2)
GCOL3: LED1.3 (A2), LED2.3 (A2), LED3.3 (A2), LED4.3 (A2), LED13.3 (A2), LED14.3 (A2), LED23.3 (A2), LED24.3 (A2)
RCOL0: LED25.1 (A1), LED26.1 (A1), LED27.1 (A1), LED28.1 (A1), LED29.1 (A1), LED30.1 (A1), LED31.1 (A1), LED32.1 (A1)
RCOL1: LED15.1 (A1), LED16.1 (A1), LED17.1 (A1), LED18.1 (A1), LED19.1 (A1), LED20.1 (A1), LED21.1 (A1), LED22.1 (A1)
RCOL2: LED5.1 (A1), LED6.1 (A1), LED7.1 (A1), LED8.1 (A1), LED9.1 (A1), LED10.1 (A1), LED11.1 (A1), LED12.1 (A1)
RCOL3: LED1.1 (A1), LED2.1 (A1), LED3.1 (A1), LED4.1 (A1), LED13.1 (A1), LED14.1 (A1), LED23.1 (A1), LED24.1 (A1)
ROW0: LED1.2 (K), LED5.2 (K), LED15.2 (K), LED25.2 (K)
ROW1: LED2.2 (K), LED6.2 (K), LED16.2 (K), LED26.2 (K)
ROW2: LED3.2 (K), LED7.2 (K), LED17.2 (K), LED27.2 (K)
ROW3: LED4.2 (K), LED8.2 (K), LED18.2 (K), LED28.2 (K)
ROW4: LED9.2 (K), LED13.2 (K), LED19.2 (K), LED29.2 (K)
ROW5: LED10.2 (K), LED14.2 (K), LED20.2 (K), LED30.2 (K)
ROW6: LED11.2 (K), LED21.2 (K), LED23.2 (K), LED31.2 (K)
ROW7: LED12.2 (K), LED22.2 (K), LED24.2 (K), LED32.2 (K)

Notes on the sheet:
LED MATRIX
