JoseFuzzNo/performer-hardware/mcu.kicad_sch

## KiCad design mcu.kicad_sch (2023-10-19)

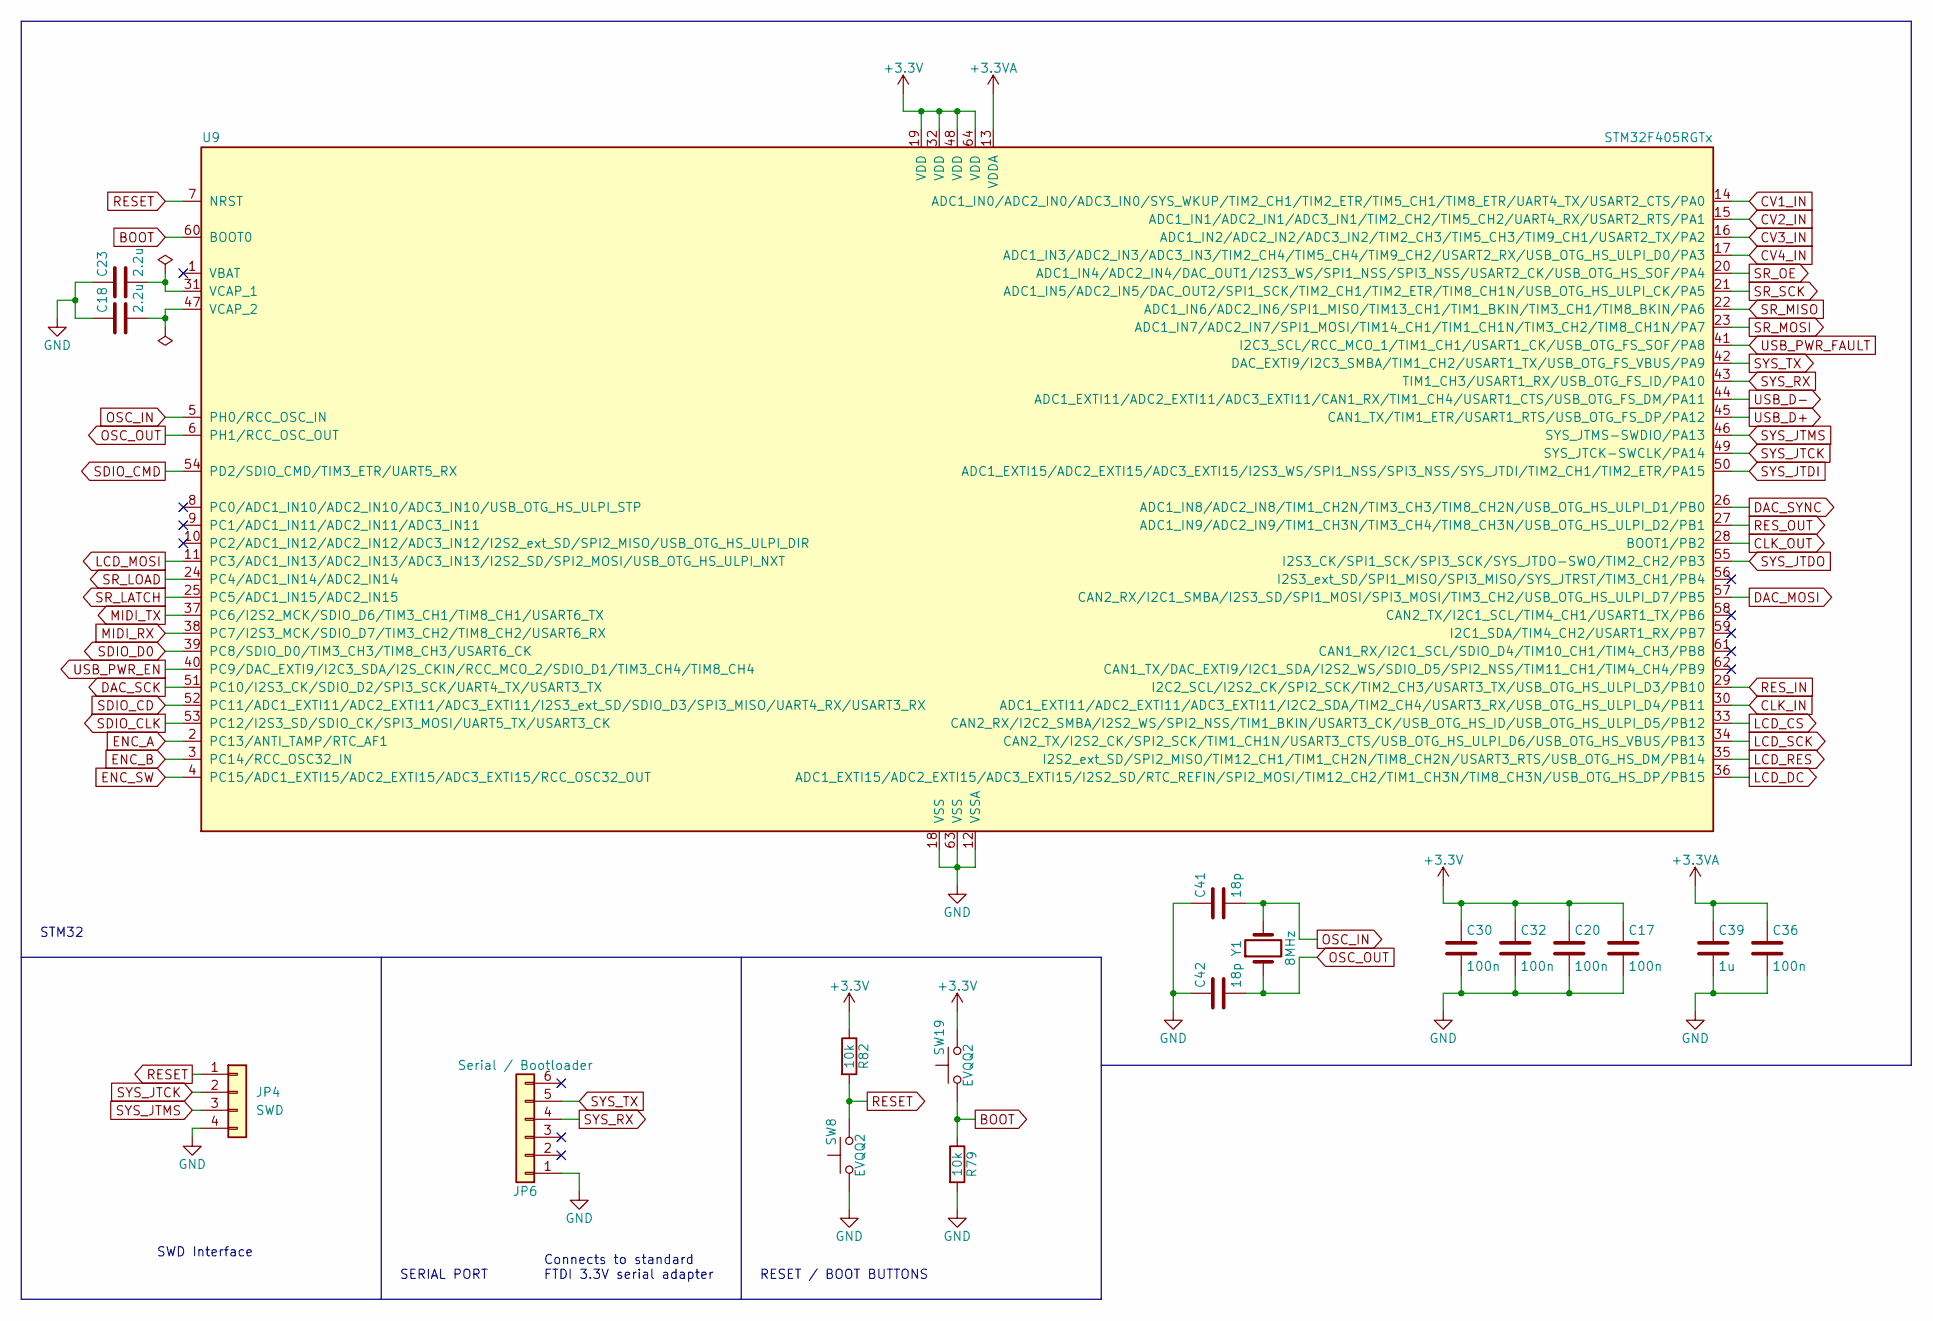
[picture p14: schematic mcu.kicad_sch]

Parts:
C17, C20, C30, C32, C36: 100n; C_0603
C18, C23: 2.2u; C_0805
C39: 1u; C_0603
C41, C42: 18p; C_0603
JP4: SWD; PinHeader_1x04_P2.54mm_Vertical
JP6: Serial / Bootloader; PinHeader_1x06_P2.54mm_Vertical
R79, R82: 10k; R_0603
SW8, SW19: EVQQ2; SW_SPST_EVQQ2
U9: STM32F405RGTx; LQFP-64_10x10mm_P0.5mm
Y1: 8MHz; Crystal_SMD_Abracon_ABM3-2Pin_5.0x3.2mm_HandSoldering

Connections:
+3.3V: C17.1, C20.1, C30.1, C32.1, R82.1, SW19.2, U9.19 (VDD), U9.32 (VDD), U9.48 (VDD), U9.64 (VDD)
+3.3VA: C36.1, C39.1, U9.13 (VDDA)
BOOT: R79.1, SW19.1, U9.60 (BOOT0)
CLK_IN: U9.30 (ADC1_EXTI11/ADC2_EXTI11/ADC3_EXTI11/I2C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)
CLK_OUT: U9.28 (BOOT1/PB2)
CV1_IN: U9.14 (ADC1_IN0/ADC2_IN0/ADC3_IN0/SYS_WKUP/TIM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)
CV2_IN: U9.15 (ADC1_IN1/ADC2_IN1/ADC3_IN1/TIM2_CH2/TIM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)
CV3_IN: U9.16 (ADC1_IN2/ADC2_IN2/ADC3_IN2/TIM2_CH3/TIM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)
CV4_IN: U9.17 (ADC1_IN3/ADC2_IN3/ADC3_IN3/TIM2_CH4/TIM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)
DAC_MOSI: U9.57 (CAN2_RX/I2C1_SMBA/I2S3_SD/SPI1_MOSI/SPI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)
DAC_SCK: U9.51 (PC10/I2S3_CK/SDIO_D2/SPI3_SCK/UART4_TX/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)
DAC_SYNC: U9.26 (ADC1_IN8/ADC2_IN8/TIM1_CH2N/TIM3_CH3/TI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)
ENC_A: U9.2 (PC13/ANTI_TAMP/RTC_AF1)
ENC_B: U9.3 (PC14/RCC_OSC32_IN)
ENC_SW: U9.4 (PC15/ADC1_EXTI15/ADC2_EXTI15/ADC3_EXTI1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)
GND: C17.2, C18.1, C20.2, C23.1, C30.2, C32.2, C36.2, C39.2, C41.1, C42.1, JP4.4, JP6.1, R79.2, SW8.1, U9.12 (VSSA), U9.18 (VSS), U9.63 (VSS)
LCD_CS: U9.33 (CAN2_RX/I2C2_SMBA/I2S2_WS/SPI2_NSS/TIM1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)
LCD_DC: U9.36 (ADC1_EXTI15/ADC2_EXTI15/ADC3_EXTI15/I2S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)
LCD_MOSI: U9.11 (PC3/ADC1_IN13/ADC2_IN13/ADC3_IN13/I2S2_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)
LCD_RES: U9.35 (I2S2_ext_SD/SPI2_MISO/TIM12_CH1/TIM1_CH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)
LCD_SCK: U9.34 (CAN2_TX/I2S2_CK/SPI2_SCK/TIM1_CH1N/USAR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)
MIDI_RX: U9.38 (PC7/I2S3_MCK/SDIO_D7/TIM3_CH2/TIM8_CH2/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)
MIDI_TX: U9.37 (PC6/I2S2_MCK/SDIO_D6/TIM3_CH1/TIM8_CH1/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)
unnamed: C18.2, U9.47 (VCAP_2)
unnamed: C23.2, U9.31 (VCAP_1)
OSC_IN: C41.2, U9.5 (PH0/RCC_OSC_IN), Y1.2
OSC_OUT: C42.2, U9.6 (PH1/RCC_OSC_OUT), Y1.1
RESET: JP4.1, R82.2, SW8.2, U9.7 (NRST)
RES_IN: U9.29 (I2C2_SCL/I2S2_CK/SPI2_SCK/TIM2_CH3/USAR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)
RES_OUT: U9.27 (ADC1_IN9/ADC2_IN9/TIM1_CH3N/TIM3_CH4/TI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)
SDIO_CD: U9.52 (PC11/ADC1_EXTI11/ADC2_EXTI11/ADC3_EXTI1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)
SDIO_CLK: U9.53 (PC12/I2S3_SD/SDIO_CK/SPI3_MOSI/UART5_TX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)
SDIO_CMD: U9.54 (PD2/SDIO_CMD/TIM3_ETR/UART5_RX)
SDIO_D0: U9.39 (PC8/SDIO_D0/TIM3_CH3/TIM8_CH3/USART6_CK)
SR_LATCH: U9.25 (PC5/ADC1_IN15/ADC2_IN15)
SR_LOAD: U9.24 (PC4/ADC1_IN14/ADC2_IN14)
SR_MISO: U9.22 (ADC1_IN6/ADC2_IN6/SPI1_MISO/TIM13_CH1/T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)
SR_MOSI: U9.23 (ADC1_IN7/ADC2_IN7/SPI1_MOSI/TIM14_CH1/T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)
SR_OE: U9.20 (ADC1_IN4/ADC2_IN4/DAC_OUT1/I2S3_WS/SPI1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)
SR_SCK: U9.21 (ADC1_IN5/ADC2_IN5/DAC_OUT2/SPI1_SCK/TIM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)
SYS_JTCK: JP4.2, U9.49 (SYS_JTCK-SWCLK/PA14)
SYS_JTDI: U9.50 (ADC1_EXTI15/ADC2_EXTI15/ADC3_EXTI15/I2S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)
SYS_JTDO: U9.55 (I2S3_CK/SPI1_SCK/SPI3_SCK/SYS_JTDO-SWO/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)
SYS_JTMS: JP4.3, U9.46 (SYS_JTMS-SWDIO/PA13)
SYS_RX: JP6.4, U9.43 (TIM1_CH3/USART1_RX/USB_OTG_FS_ID/PA10)
SYS_TX: JP6.5, U9.42 (DAC_EXTI9/I2C3_SMBA/TIM1_CH2/USART1_TX/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)
USB_D+: U9.45 (CAN1_TX/TIM1_ETR/USART1_RTS/USB_OTG_FS_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)
USB_D-: U9.44 (ADC1_EXTI11/ADC2_EXTI11/ADC3_EXTI11/CAN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)
USB_PWR_EN: U9.40 (PC9/DAC_EXTI9/I2C3_SDA/I2S_CKIN/RCC_MCO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)
USB_PWR_FAULT: U9.41 (I2C3_SCL/RCC_MCO_1/TIM1_CH1/USART1_CK/U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)

Notes on the sheet:
STM32
RESET / BOOT BUTTONS
SERIAL PORT
Connects to standard FTDI 3.3V serial adapter
SWD Interface
