JoseFuzzNo/performer-hardware/power.kicad_sch

## KiCad design power.kicad_sch (2023-10-19)

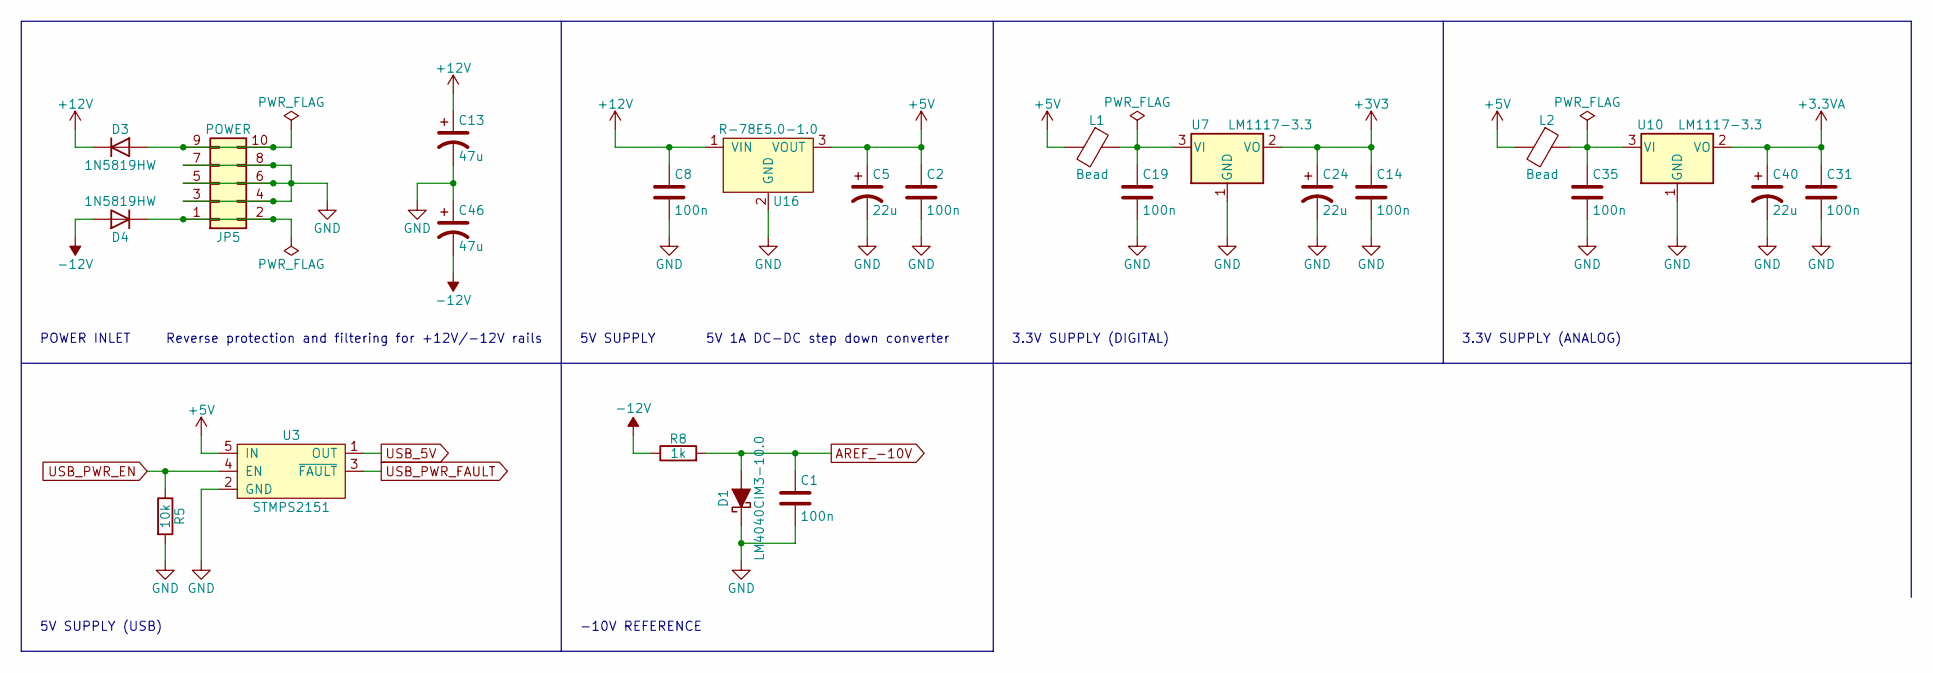
[picture p15: schematic power.kicad_sch]

Parts:
C1, C2, C8, C14, C19, C31, C35: 100n; C_0603
C5, C24, C40: 22u; CP_Elec_5x5.8
C13, C46: 47u; CP_Elec_6.3x5.7
D1: LM4040CIM3-10.0; SOT-23
D3, D4: 1N5819HW; D_SOD-123
JP5: POWER; PinHeader_2x05_P2.54mm_Vertical
L1, L2: Bead; R_0603
R5: 10k; R_0603
R8: 1k; R_0603
U3: STMPS2151; SOT-23-5
U7, U10: LM1117-3.3; SOT-223-3_TabPin2
U16: R-78E5.0-1.0; R-78E-1.0

Connections:
+3.3VA: C31.1, C40.1, U10.2 (VO)
+3V3: C14.1, C24.1, U7.2 (VO)
+5V: C2.1, C5.1, L1.2, L2.2, U3.5 (IN), U16.3 (VOUT)
+12V: C8.1, C13.1, D3.1 (K), U16.1 (VIN)
-12V: C46.2, D4.2 (A), R8.1
AREF_-10V: C1.1, D1.2 (A), R8.2
GND: C1.2, C2.2, C5.2, C8.2, C13.2, C14.2, C19.2, C24.2, C31.2, C35.2, C40.2, C46.1, D1.1 (K), JP5.3, JP5.4, JP5.5, JP5.6, JP5.7, JP5.8, R5.2, U3.2 (GND), U7.1 (GND), U10.1 (GND), U16.2 (GND)
unnamed: C19.1, L1.1, U7.3 (VI)
unnamed: C35.1, L2.1, U10.3 (VI)
unnamed: D3.2 (A), JP5.9, JP5.10
unnamed: D4.1 (K), JP5.1, JP5.2
USB_5V: U3.1 (OUT)
USB_PWR_EN: R5.1, U3.4 (EN)
USB_PWR_FAULT: U3.3 (~FAULT)

Notes on the sheet:
5V SUPPLY (USB)
5V SUPPLY
POWER INLET
3.3V SUPPLY (ANALOG)
-10V REFERENCE
5V 1A DC-DC step down converter
Reverse protection and filtering for +12V/-12V rails
3.3V SUPPLY (DIGITAL)
