JoseFuzzNo/performer-hardware/(commit log)

2023-10-10 Change to PJ398SM and PJ301BM jacks
    [button-matrix.kicad_sch, dac.kicad_sch, global.kicad_sch, jacks.kicad_sch, led-matrix.kicad_sch, mcu.kicad_sch, power.kicad_sch, sequencer.kicad_sch]
2023-10-11 Added switches for selecting the MIDI type
    [button-matrix.sch, dac.sch, global.sch, jacks.kicad_sch, jacks.sch, led-matrix.sch, mcu.sch, power.sch]
2023-10-12 Changed mini-JTAG to SWD
    [mcu.kicad_sch, sequencer.kicad_sch]
